neo3000/Ardubot-2.0/README.md

Ardubot-2.0.1
===========

Arduino Line Follower Robot 2.0
