neo3000/Ardubot-2.0/(commit log)

2012-09-11 Bug Fixes, Debug Mode, Engine System
    [Ardubot_2_0.ino, config.h]
2012-09-23 Variable Erstellung des Sensorarrays
2012-09-23 Automatische Apassung der Sensor-Pins im Array
2012-09-23 Revert "Automatische Apassung der Sensor-Pins im Array"
    This reverts commit e7b7ffb622b1164efb3701aeacf3d970ab03d1cf.
    [Ardubot_2_0.ino]
2012-09-23 Auto Anpassung der Sensor Pins
